siliconcompiler/zerosoc/(commit log)

2021-05-26 Fix some bugs
    Now smoke test works!
    - Fix mixed-up with tlul bus directions
    - Used wrong en_ifetch_i parameter for tl_adapter_sram
    - Enabled integrity check for tl_adapter_sram
    [top.sv, xbar.sv]
2021-05-26 Use prim_ram_1p_adv instead of prim_ram_1p
    This module wraps prim_ram_1p and includes logic for generating an
    rvalid signal. This change has two benefits:
    - Our previous rvalid logic was incorrect (since it didn't factor in
    write requests), resulting in a bug
    - This eliminates logic from the top-level
    [top.sv]
2021-05-26 Add basic framework for compiling C code
2021-05-26 Get simple blinky firmware running on Icebreaker!
    Required some tweaks to the design to get the size down:
    - Configure Ibex to use FPGA-optimized register file (implements RF as
    block RAM)
    - Configure Ibex to remove optional performance counters
    - Reduce size of RAM
    - Reduce # of outstanding requests for TLUL RAM adapter
    - Modify uart_core.sv to reduce size of UART FIFOs
2021-05-27 Fix simulation for new name
    [zerosoc_tb.v]
2021-05-28 Work around errors on import step for now
    [SB_HFOSC.v, build.py]
2021-05-28 Flow to reprogram bitstream without rebuilding it
2021-05-28 Working UART write!
2021-06-01 Test UART receive
2021-06-01 No longer need to convert top levels with sv2v
    Thanks to zachjs/sv2v@7ffea36ddd96568c06f71c6eb1a26c8331f3f10d
    [build.py]
2021-06-02 Expand example to exercise GPIO and UART
2021-06-02 Start working on ASIC build flow
    (Still WIP)
2021-06-08 Use FakeRAM RAM macro in ASIC build flow
    [freepdk45_zerosoc.cfg]
2021-06-11 Fix trailing comma syntax errors
    Not reported by sv2v
    [xbar.sv, zerosoc.sv]
2021-06-11 Misc. tweaks/cleanup
    - Build ASIC by default and move result to top-level
    - Fix clock name in constraints.sdc
    - Start/stop not needed anymore, plus target override now works
    [build.py]
2021-07-02 Cleanup + bugfix sv2v flow
    [build.py, top_icebreaker.v]
2021-07-05 First draft of ZeroSoC padring
    Using Yosys fake I/O library, no power routing yet
2021-07-06 WIP building ZeroSoC with floorplan
    Status: gets up to route stage now, fails due to inaccessible access point
    Main changes:
    - Random fixes to padring
    - Add wrapper/dummy cells for padring (wraps iocells.lef)
    - No more top-level I/O in top_asic.v, since OpenROAD looks for pins.
    Instead use wires with (* keep *) attribute.
    This commit relies on the following hacks in SC:
    - Don't attempt to read macro liberty files when missing
    - Don't run CTS
    - Don't include macro HALO in DEF
    Also uses patched OH padring to fix width of *_dout ports.
    [build.py, floorplan.py]
2021-07-08 Switch iocells.lef to same mfg grid as freepdk45
    Otherwise, OpenROAD uses the coarser grid and we get pin access errors.
2021-07-22 Rework floorplan to avoid routing congestion
    Just use a single RAM macro, and keep it out of the core area.
    [build.py, floorplan.py, prim_sky130_ram_1p.v, top_icebreaker.v, zerosoc.sv]
2021-08-07 Get rid of freepdk45 stuff
    Focusing on Skywater for now, can reintroduce later if we want to demo
    multiple nodes.
    [freepdk45_zerosoc.cfg]
2021-08-07 Change flow handling due to SC updates
2021-08-08 Full core + top build flow
2021-08-08 Parameter to set thread count for route
2021-08-08 Fix bug copying build outputs
    [build.py]
2021-08-09 Fix incorrect pin offset
2021-08-09 Add power pads
2021-08-10 Don't set threads since we now default to max
2021-08-10 Fix pin numbering
2021-08-10 Bugfix
    no more [-1]!!
    [build.py]
2021-08-13 Full power distribution
    Whew
2021-08-17 Make sure core dimensions are std-cell aligned
    This is necessary for DRC to pass and also makes routing faster.
    - Adjust margin between placement area and core boundary to be multiple
    of 1 that's also a multiple of std cell sizes.
    - Switch from wrapped GPIO to regular (wrapped one has a height that
    doesn't allow us to meet dimension constraints)
    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
    [build.py]
2021-08-18 Include names of power pins in specialnet defs
2021-08-18 Having more than one vdd/vss pin causes LVS to fail
    But we also need at least one...
2021-08-18 Top-level LVS passing!!
    Changes required:
    - Connect power-ring in Verilog netlist
    - Run through synthesis
    - Add 1 each of top-level power pins (under correct pads)
    [asic_top.v, build.py]
2021-08-19 More new API bugfixes
    [build.py]
2021-08-19 Give option to turn LVS/DRC off for full flow
2021-08-23 Tighter floorplan DRC and LVS clean!
    [build.py]
2021-08-24 Shink die (but break DRC)
2021-08-26 Small chip DRC/LVS clean!
    Needed to go back to wrapped GPIO cells, since it seemed like the
    OpenROAD router was having a really hard time not creating DRC
    violations when routing to the less uniform pins on the foundry cells.
    In order to support this, we also had to add extra bits of metal on the
    padring side to connect the power pads to the wiring. I did it this way
    since we needed to have a couple power pins for LVS, but OpenROAD
    doesn't seem to like pins that extend beyond the core area.
    [build.py]
2021-09-03 Reorder synopt and floorplan to match asicflow
    The TCL scripts also changed in such a way that the old order broke.
    [build.py]
2021-09-03 Fix mismatched wire widths
    [prim_sky130_ram_1p.v, zerosoc.sv]
2021-09-07 Fix up clock gate
    [build.py]
2021-09-14 More changes for new API
    Mostly flowgraph
2021-09-15 Some changes, no more routing congestion
    Main thing: increased diesize by 1.2^2 and placed north and east pads
    along the first half of each side. Turns out the routing congestion was
    actually resulting in violations (that were not being caught by
    top-level DRC). It seems like the congestion is related to routing to
    I/O around the SRAM: the DRC errors were wires that were overlapping
    with the SRRAM boundary.
    I also added the tool option to set placement density to 0.15 and added
    a call to insert_vias().
    [build.py, floorplan.py]
2021-09-15 Fix bug with power pad positioning
    [floorplan.py]
2021-09-15 Add specialnets to wire up stdcells/RAM
    With automatic via insertion, we can hook the power grid up to our
    standard cells and RAM macro by placing specialnets that short their power
    rails.
    LVS clean!!
    [floorplan.py]
2021-09-15 Correct coresize and add power connection bump
    Top-level DRC clean, LVS should be clean once it's fixed to not
    black-box the core.
    [floorplan.py]
2021-09-21 Avoid need for OpenROAD netlist hack
    The issue seems to be with port ordering. As a work around for now, we
    can rename vdd/vss to ensure Yosys puts them first when instantiating
    asic_core.
    [asic_core.v, asic_top.v, build.py, floorplan.py]
2021-10-08 Fix up GPIO tieoffs
    - Bug: wasn't tying off every pad, just the first one!
    - Need to connect high _h signals to vddio instead of vdd, which
    requires bringing vddio into the core
    - Need to tie off enable_inp_h to either tie_lo_esd or tie_hi_esd, so
    needed to expand tech_cfg (and make it an inout) to bring these into the
    core.
    [asic_core.v, asic_top.v, build.py]
2021-10-16 Some updates
    - Update flowgraph setup for changed schema
    - Reorder sources for Surelog
2021-10-16 Simplify build script flow control
2021-10-20 Add RAM tieoffs
    Brings back routing congestion, but not sure it's worth the time to fix
    this... will add a flag to ignore it in SC.
    Tried moving the RAM to the left as well, but this results in tons of
    LVS errors for a reason I haven't figured out (seems to be shorting
    power?)
    [prim_sky130_ram_1p.v]
2021-10-26 Update flowgraph for API changes
    - Everything needs import step
    - asicflow now supports SV, so no need for separate SV flow
2021-11-03 Update custom integration flow to use new flow API
2021-11-04 Add sv flowarg
2021-11-11 Build script tweaks to fix FPGA build
    [build.py]
2021-11-11 Add ice40-specific clock gate primitive
    Doesn't actually implement clock gate, just does pass through.
    [build.py, prim_ice40_clock_gating.v]
2021-11-11 Test that core build on its own gives clean results
    In the past I've seen weird cases with DRC errors at core-level but not
    top, this will catch that (and if we do catch this again, should
    probably root-cause why they're not caught at the top-level).
    [build.py]
2021-12-02 Fix up some timing-related things
    [build.py]
2021-12-04 Fix test for LVS change
    [build.py]
2021-12-20 Updates for SC 0.3
    - 'eda' schema change
    - 'flowarg', 'sv' replaced by 'frontend'
    [build.py]
2022-03-09 Changes for split up flows in SC
2022-03-23 Fix new DRC/LVS issues
    - Core DRC: need to fudge RAM position to ensure pins align with routing
    grid, otherwise the new OpenROAD overlaps with the metal3 obstructions
    in the RAM LEF.
    - Top LVS: need to eliminate VDDIO pads that don't get touched by
    router. Not sure what the cause of this new problem is.
    [floorplan.py]
2022-05-20 Update library 'copy' field so the build works with the remote flow
2022-07-11 Add workaround for remote runs altering steplist
    [build.py]
2023-02-28 inital work to fix floorplan.py
    [floorplan.py]
2023-03-01 add global connect scripts and power grid
2023-03-30 update build.py to fix sv parsing in surelog
    [build.py]
2023-04-16 add CI for currently installed version of SC + head of SC
2023-06-12 update clk and remove dpo bypass as it is no longer needed
    [build.py]
2023-08-31 fix lef generation and bump runtimes
    [build.py]
2023-09-01 Switch docker image to main branch
2023-12-12 switch to use lambdapdk + use rtlmp
2024-01-04 switch to use lambdalib padring
2024-01-04 ensure SRAM is connected to power grid
2024-03-13 fix name change in yosys
    [build.py]
2024-07-08 switch to clean from resume
2024-07-31 make use of swap_library routine
    [build.py]
2024-08-05 breakout libraries and switch to lambdalib
2024-08-05 correct zerosoc top import
    [make.py, zerosoc_top.py]
2024-08-29 fix loading of core
    [make.py]
2024-09-17 fix placement based on new LL definition in schema
    [floorplan.py]
2024-10-24 fix calls to signoff
    [make.py]
2024-12-02 fix settings for asicflow
    [make.py]
2024-12-02 fix power grid and padring steps
    [floorplan.py]
2025-01-15 fix pin ordering on core
    [floorplan.py]
2025-05-27 fix quotes for defines
    [zerosoc_core.py]
2025-09-16 fix naming to match SC main
    [make.py]
2025-09-24 fix use of get_task
    [make.py]
